DreadedX/car-stereo/README.md

# Peugeot 207 Bluetooth music receiver
My Peugeot has bluetooth, but only for calling.
This project aims to build a bluetooth receiver to attached to the aux in in the glovebox.
