DreadedX/car-stereo/hardware/receiver.kicad_pcb

## KiCad design hardware/receiver.kicad_pcb (2023-03-31)

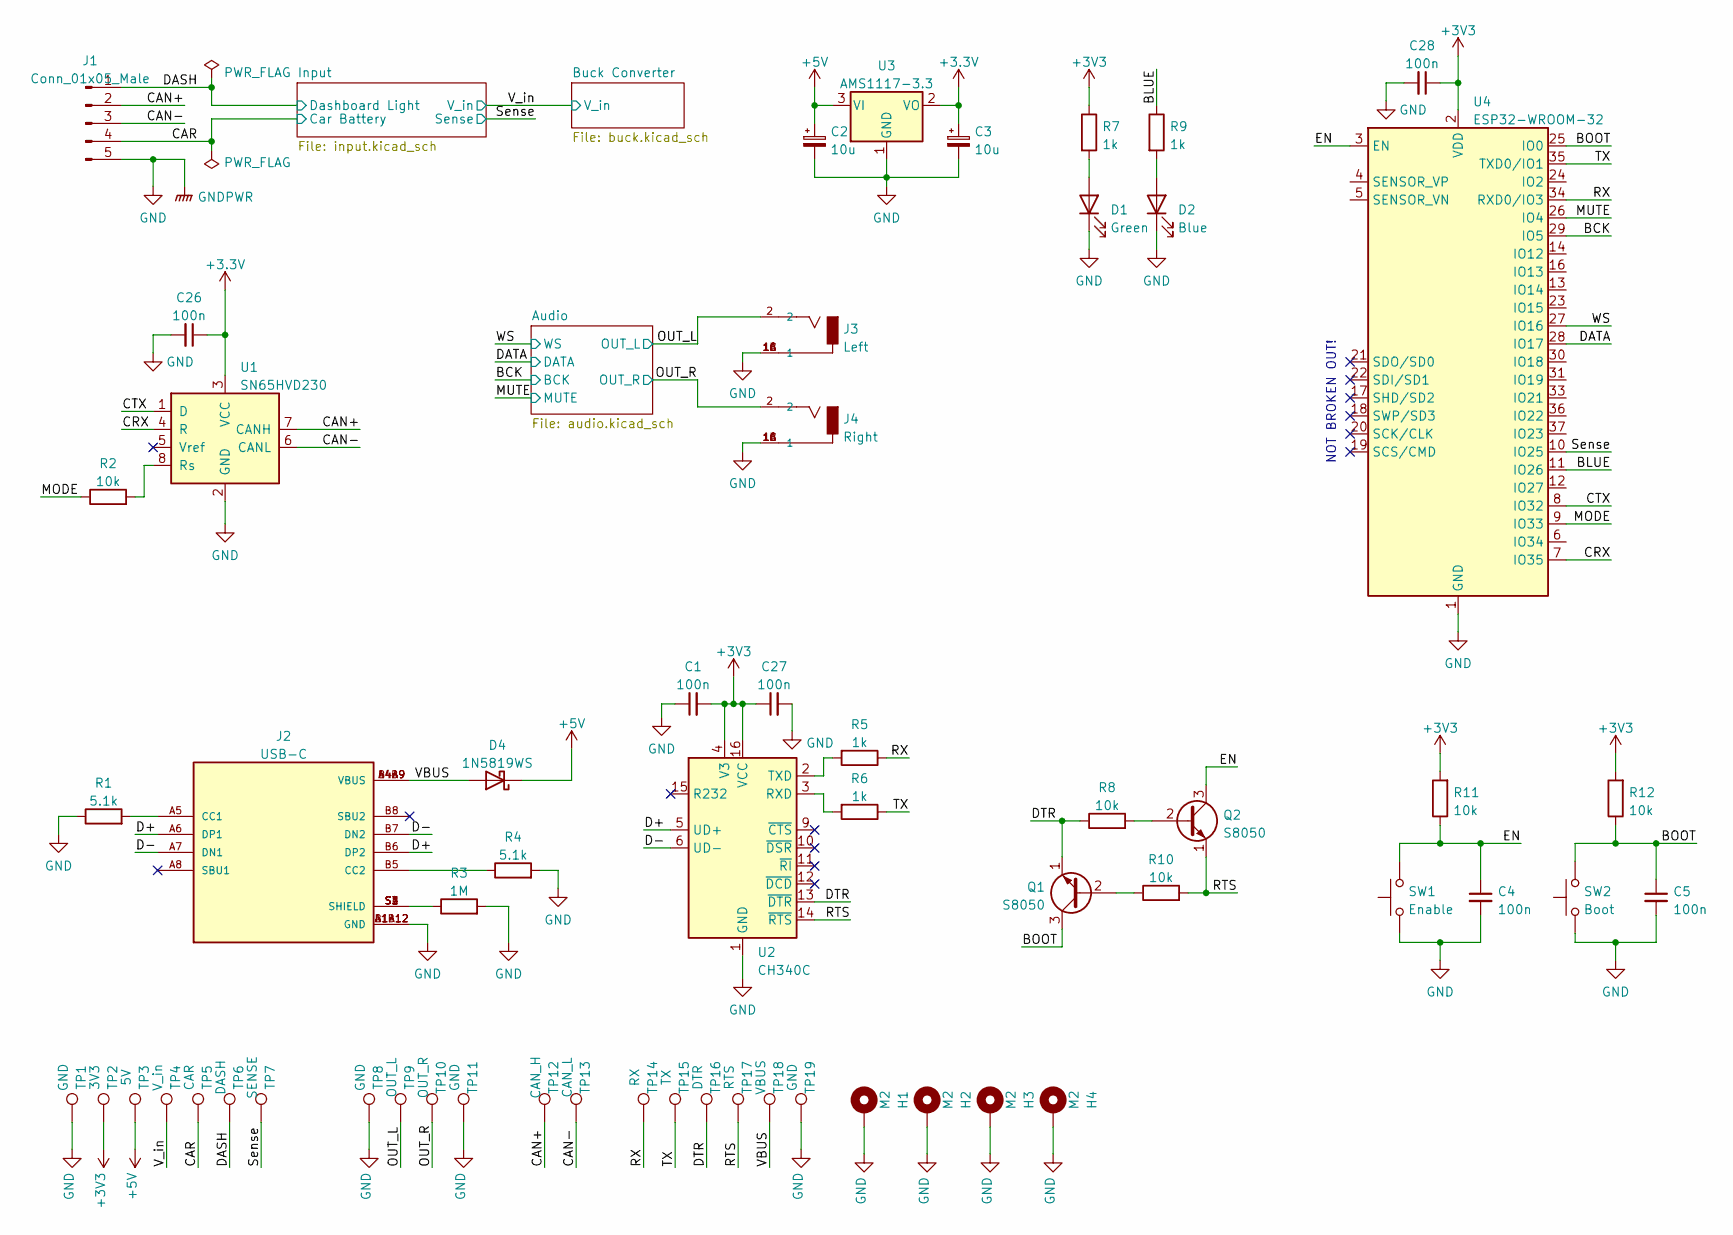
[picture p1: schematic receiver.kicad_sch]

Parts:
C1, C4, C5, C26, C27, C28: 100n; C_0402_1005Metric; LCSC# C1525
C2, C3: 10u; C_1206_3216Metric; LCSC# C7171
D1: Green; LED_0603_1608Metric; LCSC# C72043
D2: Blue; LED_0603_1608Metric; LCSC# C72041
D4: 1N5819WS; D_SOD-323; LCSC# C191023
H1, H2, H3, H4: M2; MountingHole_2.2mm_M2_ISO14580_Pad
J1: Conn_01x05_Male; JST_XH_S5B-XH-A-1_1x05_P2.50mm_Horizontal
J2: USB-C; HRO_TYPE-C-31-M-12; PARTREV A; LCSC# C165948
J3: Left; CUI_RCJ-013; PART_REV B
J4: Right; CUI_RCJ-013; PART_REV B
Q1, Q2: S8050; SOT-23; LCSC# C2146
R1, R4: 5.1k; R_0402_1005Metric; LCSC# C25905
R2, R8, R10, R11, R12: 10k; R_0402_1005Metric; LCSC# C25744
R3: 1M; R_0402_1005Metric; LCSC# C26083
R5, R6, R7, R9: 1k; R_0402_1005Metric; LCSC# C11702
SW1: Enable; SW_SPST_SKQG_WithStem
SW2: Boot; SW_SPST_SKQG_WithStem
TP1, TP8, TP11, TP19: GND; TestPoint_Pad_D1.0mm
TP2: 3V3; TestPoint_Pad_D1.0mm
TP3: 5V; TestPoint_Pad_D1.0mm
TP4: V_in; TestPoint_Pad_D1.0mm
TP5: CAR; TestPoint_Pad_D1.0mm
TP6: DASH; TestPoint_Pad_D1.0mm
TP7: SENSE; TestPoint_Pad_D1.0mm
TP9: OUT_L; TestPoint_Pad_D1.0mm
TP10: OUT_R; TestPoint_Pad_D1.0mm
TP12: CAN_H; TestPoint_Pad_D1.0mm
TP13: CAN_L; TestPoint_Pad_D1.0mm
TP14: RX; TestPoint_Pad_D1.0mm
TP15: TX; TestPoint_Pad_D1.0mm
TP16: DTR; TestPoint_Pad_D1.0mm
TP17: RTS; TestPoint_Pad_D1.0mm
TP18: VBUS; TestPoint_Pad_D1.0mm
U1: SN65HVD230; SOIC-8_3.9x4.9mm_P1.27mm; LCSC# C12084
U2: CH340C; SOIC-16_3.9x9.9mm_P1.27mm; LCSC# C84681
U3: AMS1117-3.3; SOT-223-3_TabPin2; LCSC# C6186
U4: ESP32-WROOM-32; LCSC# C95209

Connections:
/BCK: U4.29 (IO5); also elsewhere on the board
/BLUE: R9.1, U4.11 (IO26)
/BOOT: C5.1, Q1.3 (C), R12.1, SW2.2, U4.25 (IO0)
/CAN+: J1.2, TP12.1, U1.7 (CANH)
/CAN-: J1.3, TP13.1, U1.6 (CANL)
/CRX: U1.4 (R), U4.7 (IO35)
/CTX: U1.1 (D), U4.8 (IO32)
/D+: J2.A6 (DP1), J2.B6 (DP2), U2.5 (UD+)
/D-: J2.A7 (DN1), J2.B7 (DN2), U2.6 (UD-)
/DASH: J1.1, TP6.1; also elsewhere on the board
/DATA: U4.28 (IO17); also elsewhere on the board
/DTR: Q1.1 (E), R8.1, TP16.1, U2.13 (~DTR)
/EN: C4.1, Q2.3 (C), R11.1, SW1.2, U4.3 (EN)
/MODE: R2.1, U4.9 (IO33)
/MUTE: U4.26 (IO4); also elsewhere on the board
/OUT_L: J3.2, TP9.1; also elsewhere on the board
/OUT_R: J4.2, TP10.1; also elsewhere on the board
/RTS: Q2.1 (E), R10.2, TP17.1, U2.14 (~RTS)
/RX: R5.1, TP14.1, U4.34 (RXD0/IO3)
/Sense: TP7.1, U4.10 (IO25); also elsewhere on the board
/TX: R6.1, TP15.1, U4.35 (TXD0/IO1)
/V_in: TP4.1; also elsewhere on the board
/WS: U4.27 (IO16); also elsewhere on the board
GND: C1.1, C2.2, C3.2, C4.2, C5.2, C26.2, C27.2, C28.2, D1.1 (K), D2.1 (K), H1.1, H2.1, H3.1, H4.1, J1.5, J2.A1B12 (GND), J2.B1A12 (GND), J3.1A (1), J3.1B (1), J3.1C (1), J4.1A (1), J4.1B (1), J4.1C (1), R1.1, R3.2, R4.2, SW1.1, SW2.1, TP1.1, TP8.1, TP11.1, TP19.1, U1.2 (GND), U2.1 (GND), U3.1 (GND), U4.1 (GND), U4.15 (GND), U4.38 (GND), U4.39 (GND); also elsewhere on the board
unnamed: D1.2 (A), R7.2
unnamed: D2.2 (A), R9.2
unnamed: J2.A5 (CC1), R1.2
unnamed: J2.B5 (CC2), R4.1
unnamed: J2.S1 (SHIELD), J2.S2 (SHIELD), J2.S3 (SHIELD), J2.S4 (SHIELD), R3.1
unnamed: Q1.2 (B), R10.1
unnamed: Q2.2 (B), R8.2
unnamed: R2.2, U1.8 (Rs)
unnamed: R6.2, U2.3 (RXD)
unnamed: R5.2, U2.2 (TXD)

Notes on the sheet:
NOT BROKEN OUT!

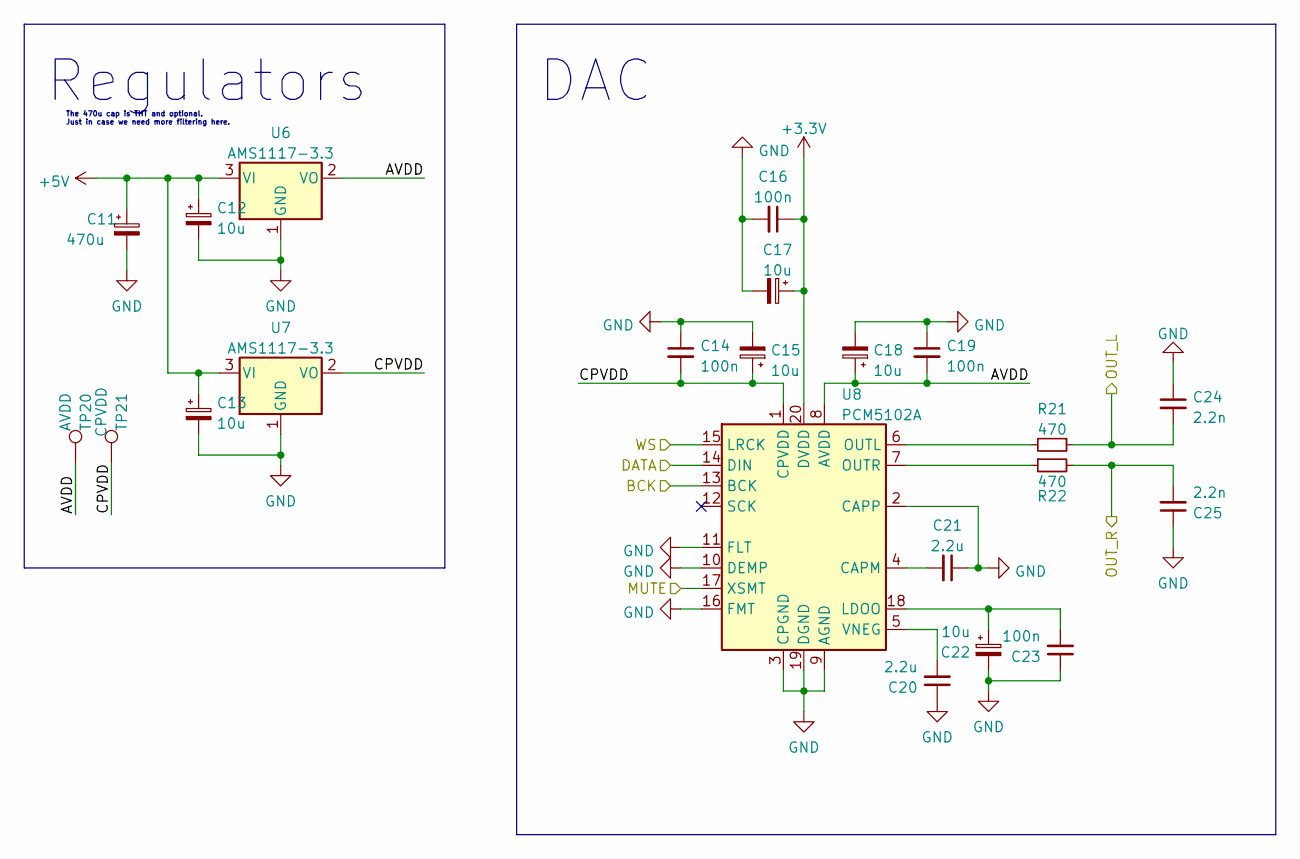
[picture p2: schematic audio.kicad_sch]

Parts:
C11: 470u; CP_Radial_D5.0mm_P2.50mm
C12, C13, C15, C17, C18, C22: 10u; C_1206_3216Metric; LCSC# C7171
C14, C16, C19, C23: 100n; C_0402_1005Metric; LCSC# C1525
C20, C21: 2.2u; C_0402_1005Metric; LCSC# C12530
C24, C25: 2.2n; C_0402_1005Metric; LCSC# C1531
R21, R22: 470; R_0402_1005Metric; LCSC# C25117
TP20: AVDD; TestPoint_Pad_D1.0mm
TP21: CPVDD; TestPoint_Pad_D1.0mm
U6, U7: AMS1117-3.3; SOT-223-3_TabPin2; LCSC# C6186
U8: PCM5102A; TSSOP-20_4.4x6.5mm_P0.65mm; LCSC# C107671

Connections:
/Audio/AVDD: C18.1, C19.2, TP20.1, U6.2 (VO), U8.8 (AVDD)
/Audio/CPVDD: C14.2, C15.1, TP21.1, U7.2 (VO), U8.1 (CPVDD)
/BCK: U8.13 (BCK); also elsewhere on the board
/DATA: U8.14 (DIN); also elsewhere on the board
/MUTE: U8.17 (XSMT); also elsewhere on the board
/OUT_L: C24.2, R21.1; also elsewhere on the board
/OUT_R: C25.2, R22.2; also elsewhere on the board
/WS: U8.15 (LRCK); also elsewhere on the board
GND: C11.2, C12.2, C13.2, C14.1, C15.2, C16.2, C17.2, C18.2, C19.1, C20.1, C21.1, C22.2, C23.1, C24.1, C25.1, U6.1 (GND), U7.1 (GND), U8.2 (CAPP), U8.3 (CPGND), U8.9 (AGND), U8.10 (DEMP), U8.11 (FLT), U8.16 (FMT), U8.19 (DGND); also elsewhere on the board
unnamed: C21.2, U8.4 (CAPM)
unnamed: C22.1, C23.2, U8.18 (LDOO)
unnamed: R21.2, U8.6 (OUTL)
unnamed: R22.1, U8.7 (OUTR)
unnamed: C20.2, U8.5 (VNEG)

Notes on the sheet:
The 470u cap is THT and optional. Just in case we need more filtering here.
Regulators
DAC

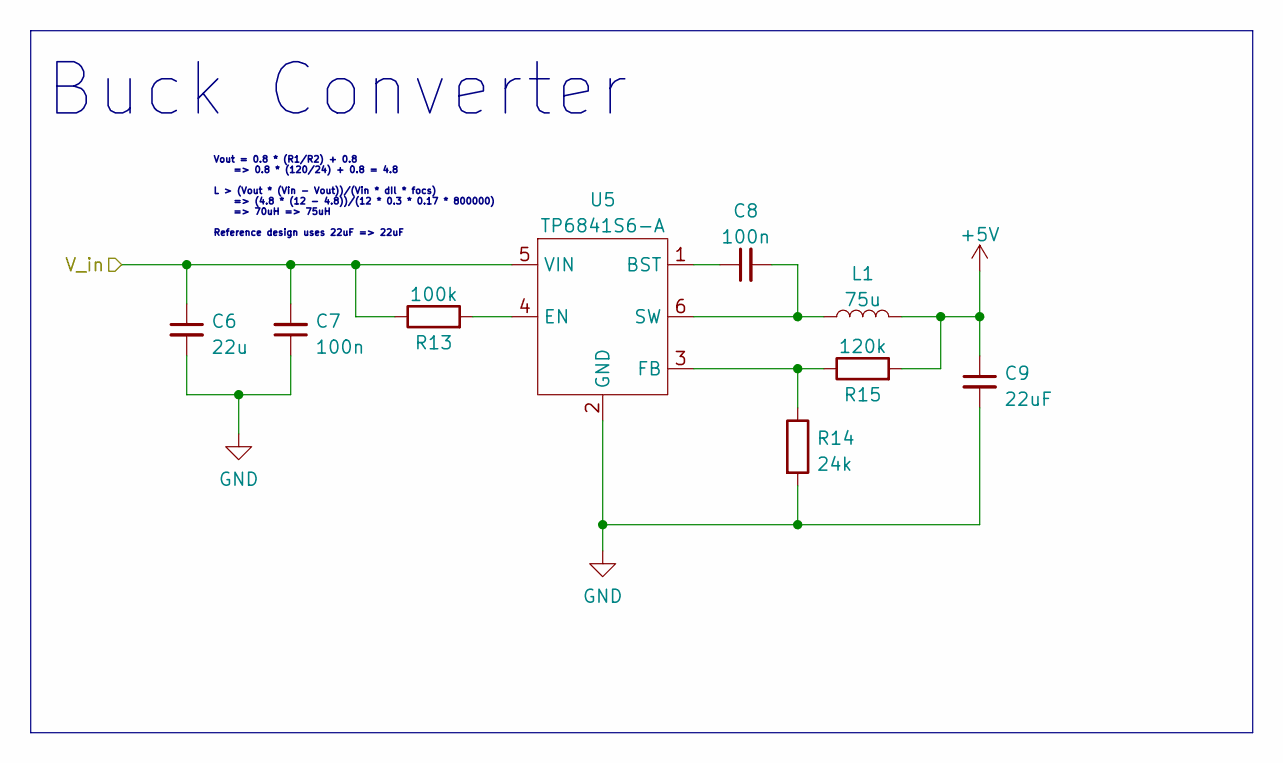
[picture p3: schematic buck.kicad_sch]

Parts:
C6: 22u; C_1206_3216Metric; LCSC# C12891
C7, C8: 100n; C_0402_1005Metric; LCSC# C1525
C9: 22uF; C_0603_1608Metric; LCSC# C59461
L1: 75u; IND-SMD_L4.0-W4.0_FNR40XXS; LCSC# C167848
R13: 100k; R_0402_1005Metric; LCSC# C25741
R14: 24k; R_0402_1005Metric; LCSC# C25769
R15: 120k; R_0402_1005Metric; LCSC# C25750
U5: TP6841S6-A; SOT-23-6; LCSC# C2844924

Connections:
/V_in: C6.1, C7.2, R13.1, U5.5 (VIN); also elsewhere on the board
GND: C6.2, C7.1, C9.2, R14.2, U5.2 (GND); also elsewhere on the board
unnamed: C8.1, U5.1 (BST)
unnamed: R13.2, U5.4 (EN)
unnamed: R14.1, R15.1, U5.3 (FB)
unnamed: C8.2, L1.1, U5.6 (SW)

Notes on the sheet:
Buck Converter
Vout = 0.8 * (R1/R2) + 0.8 => 0.8 * (120/24) + 0.8 = 4.8 L > (Vout * (Vin - Vout))/(Vin * dIl * focs) => (4.8 * (12 - 4.8))/(12 * 0.3 * 0.17 * 800000) => 70uH => 75uH Reference design uses 22uF => 22uF

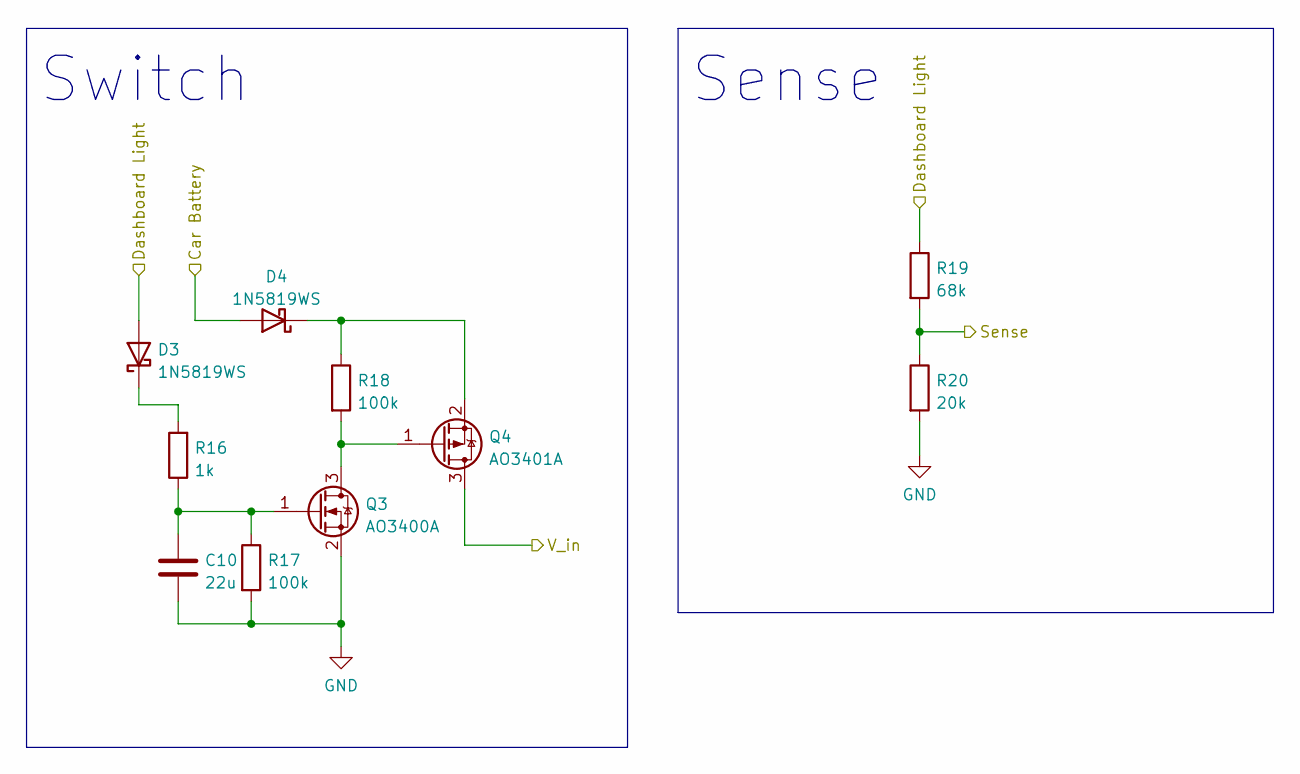
[picture p4: schematic input.kicad_sch]

Parts:
C10: 22u; C_1206_3216Metric; LCSC# C12891
D3, D4: 1N5819WS; D_SOD-323; LCSC# C191023
Q3: AO3400A; SOT-23; LCSC# C20917
Q4: AO3401A; SOT-23; LCSC# C15127
R16: 1k; R_0402_1005Metric; LCSC# C11702
R17, R18: 100k; R_0402_1005Metric; LCSC# C25741
R19: 68k; R_0402_1005Metric; LCSC# C36871
R20: 20k; R_0402_1005Metric; LCSC# C25765

Connections:
/DASH: D3.2 (A), R19.1; also elsewhere on the board
/Sense: R19.2, R20.1; also elsewhere on the board
/V_in: Q4.3 (D); also elsewhere on the board
GND: C10.2, Q3.2 (S), R17.2, R20.2; also elsewhere on the board
unnamed: D3.1 (K), R16.2
unnamed: Q3.3 (D), Q4.1 (G), R18.2
unnamed: C10.1, Q3.1 (G), R16.1, R17.1

Notes on the sheet:
Switch
Sense

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
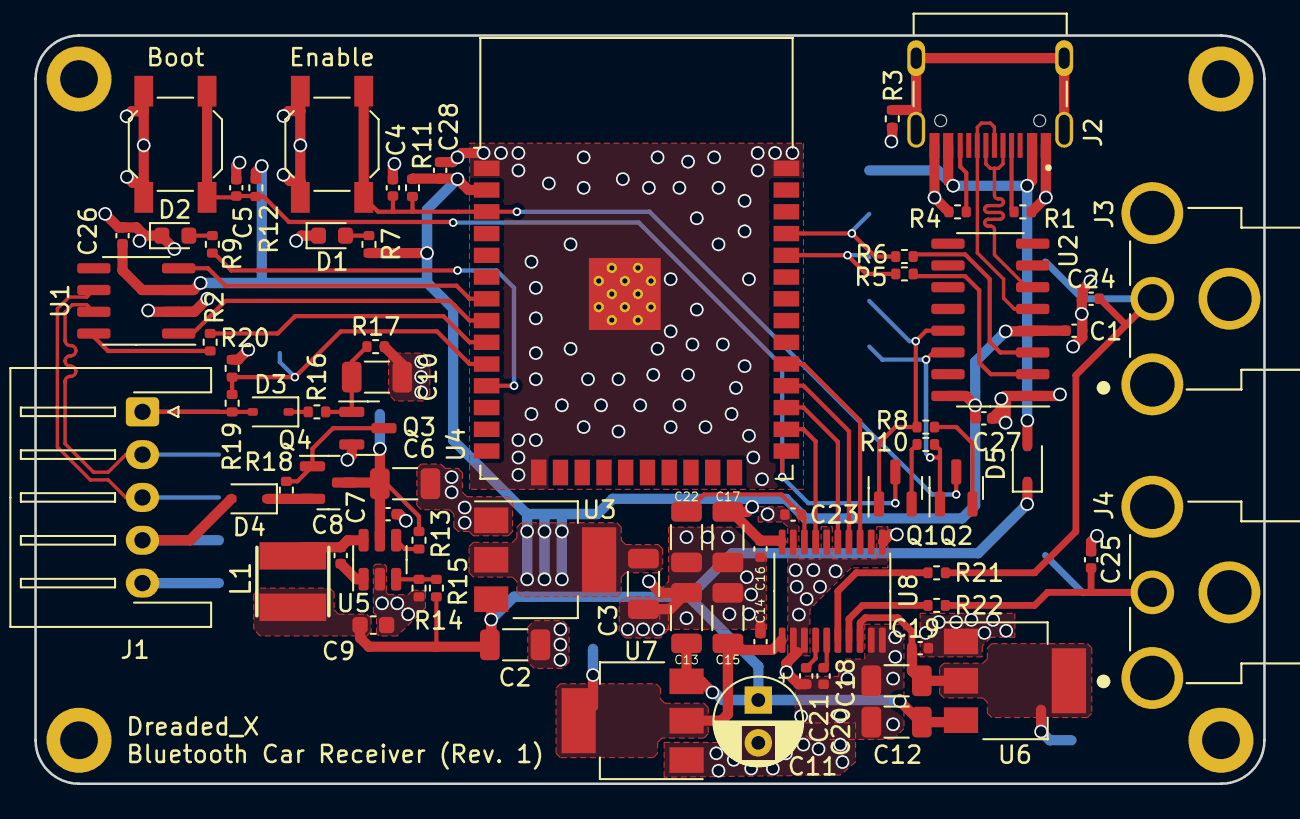
[picture p5: board receiver.kicad_pcb from above]

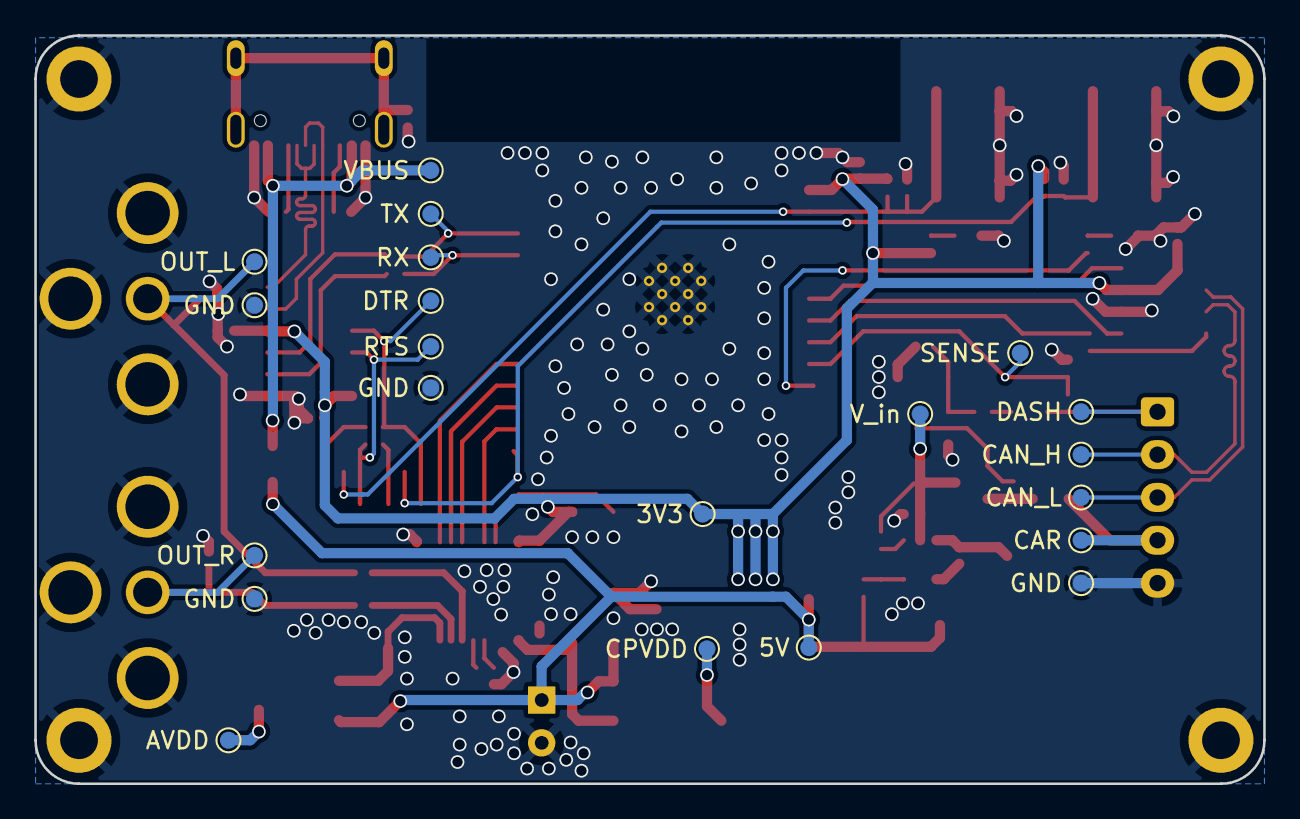
[picture p6: board receiver.kicad_pcb from below]

Board: 2 copper layers, 71.8 x 43.7 mm, 99 parts (21 on the bottom side), 53 nets.

Other parts of the board:
D5: 1N5819WS; D_SOD-323
