DreadedX/car-stereo/hardware/buck/buck.kicad_pcb

## KiCad design hardware/buck/buck.kicad_pcb (2022-05-26)

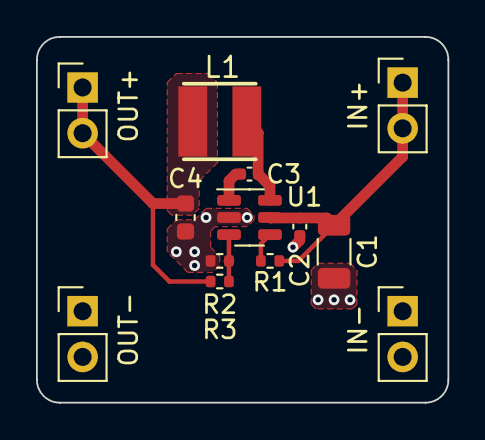
[picture p7: board buck.kicad_pcb from above]

Board: 2 copper layers, 22.9 x 20.3 mm, 13 parts (0 on the bottom side), 7 nets.

Parts:
C1: 22u; C_1206_3216Metric
C2, C3: 100n; C_0402_1005Metric
C4: 22uF; C_0603_1608Metric
J1: IN+; PinHeader_1x02_P2.54mm_Vertical
J2: IN-; PinHeader_1x02_P2.54mm_Vertical
J3: OUT+; PinHeader_1x02_P2.54mm_Vertical
J4: OUT-; PinHeader_1x02_P2.54mm_Vertical
L1: 75u; IND-SMD_L4.0-W4.0_FNR40XXS
R1: 100k; R_0402_1005Metric
R2: 24k; R_0402_1005Metric
R3: 120k; R_0402_1005Metric
U1: TP6841S6-A; SOT-23-6

Connections:
+5V: C4.1, J3.1, J3.2, L1.2, R3.2
GND: C1.2, C2.1, C4.2, J2.1, J2.2, J4.1, J4.2, R2.2, U1.2 (GND)
unnamed: C3.1, U1.1 (BST)
unnamed: C3.2, L1.1, U1.6 (SW)
unnamed: R1.2, U1.4 (EN)
unnamed: R2.1, R3.1, U1.3 (FB)
Vin: C1.1, C2.2, J1.1, J1.2, R1.1, U1.5 (VIN)
