DreadedX/car-stereo/software/main/src/main.cpp

#include <cmath>

#include "esp_log.h"
#include "esp_system.h"

#include "storage.h"
#include "i2s.h"
#include "bluetooth.h"
#include "avrcp.h"
#include "a2dp.h"
#include "twai.h"
#include "volume.h"
#include "leds.h"

#define APP_TAG "APP"

extern "C" void app_main() {
	ESP_LOGI(APP_TAG, "Starting Car Stereo");
	ESP_LOGI(APP_TAG, "Available Heap: %u", esp_get_free_heap_size());

	leds::init();

	nvs::init();
	i2s::init();
	bluetooth::init();

	avrcp::init();
	a2dp::init();

	a2dp::connect_to_last();

	twai::init();
	volume_controller::init();
}
