DreadedX/car-stereo/(commit log)

2022-05-21 Added basis for hardware design
    [receiver.kicad_pcb, receiver.kicad_sch]
2022-05-22 Worked on schematics and added some parts
    [receiver.kicad_pcb]
2022-05-25 Fixed: Not set to discoverable if there is no last device
    [a2dp.cpp]
2022-05-26 Worked on schematic and split parts into seperate schematics
    [audio.kicad_sch, buck.kicad_sch, input.kicad_sch, receiver.kicad_pcb, receiver.kicad_sch]
2022-05-26 Put buck converter on seperate PCB for validation
    [buck.kicad_pcb, buck.kicad_sch]
2022-05-26 Created falstad circuit simulation for the input power switch
2022-05-26 Started work on a companion app to read out things like battery life
2022-06-09 Fixed flipped transistor
    [input.kicad_sch]
2022-06-09 Wrote CAN Bus data visualizer
2022-06-11 Started work on CAN bus
2022-06-13 Implemented CAN Bus listening
2022-06-13 Play/pause using the forward button on the steering wheel
2022-06-14 Refactored and current playstatus is now received from device
2022-06-14 Forgot to store previous button state
2022-06-15 MultiPurposeButton now uses a timer to time the long and short press
    [helper.cpp, helper.h]
2022-06-15 Buttons should now only work if we are on AUX2
2022-06-16 Seek forward and backward using scroll wheel in car
2022-06-16 Only listen for buttons to prevent weird issues from occuring
2022-06-20 Started work on using TWAI instead of external CAN bus
2022-06-21 Reduced some logging, and added id filter
2022-06-22 Fixed mask and made buttons functional again
    [twai.cpp]
2022-07-04 Audio data now goes through a ringbuffer first so we can hopefully smooth out the sequence number errors
    [a2dp.cpp, i2s.cpp, i2s.h]
2022-07-07 Alternative power input switch system
2022-07-07 Finished first iteration of the PCB
    [audio.kicad_sch, buck.kicad_sch, input.kicad_sch, receiver.kicad_pcb, receiver.kicad_sch]
2022-07-07 Made corners rounded and added mounting holes
    [buck.kicad_sch, receiver.kicad_pcb, receiver.kicad_sch]
2022-07-07 Configured thermal reliefs for mounting holes
    [receiver.kicad_pcb]
2022-09-29 Moved pin config into seperate config file
2022-09-29 Added pin config for production
2023-03-31 Updated to new version of KiCad and made some small changes to the design
    [audio.kicad_sch, buck.kicad_sch, input.kicad_sch, receiver.kicad_pcb, receiver.kicad_sch]
2023-04-01 Added menuconfig option to switch between prototype and eventual production hardware
2023-04-01 Added led to indicate bluetooth status
